yoursc/Robot/README.md

# 安防巡逻机器人，软硬件综合整理 #

--树莓派主板控制

--ROS系统

--STM32下位机
