yoursc/Robot/Code/Pi_ROS/ReadMe.md

系统核心层部署，本目录存放在树莓派上的部署步骤及运行的相关代码。

树莓派部署：
	安装Ubuntu Mate 最新版本
	安装软件
		RealVNC  远程控制工具
		minicom  串口调试工具
		pyserial python串口库
	设置静态IP（有线网络）
	使用ROS官方源安装完整的ROS
	下载使用到的ROS源码包
		usb_cam
		rosserial	git clone https://github.com/ros-drivers/rosserial.git
