yoursc/Robot/Code/STM32_Car/ReadMe.md

本目录存放STM32下位机。
程序代码参考：淘宝店平衡小车之家

芯片型号：STM32F103C8T6

串口通讯
波特率：115,200
数据位：8
停止位：1
