yoursc/Robot/论文/毕业设计调研_曹沛文.docx

应用场景

家庭机器人：安防、监控、互动、娱乐

细化功能

全向移动

视频云台

机械手

自主充电

高温自保护

烟雾检测

智能避障

语音识别

语音命令

人脸识别

远程控制

技术路线

评估：难度、时间精力、话费

工作计划
