yoursc/Robot/工程图/组装_安装板.SLDASM

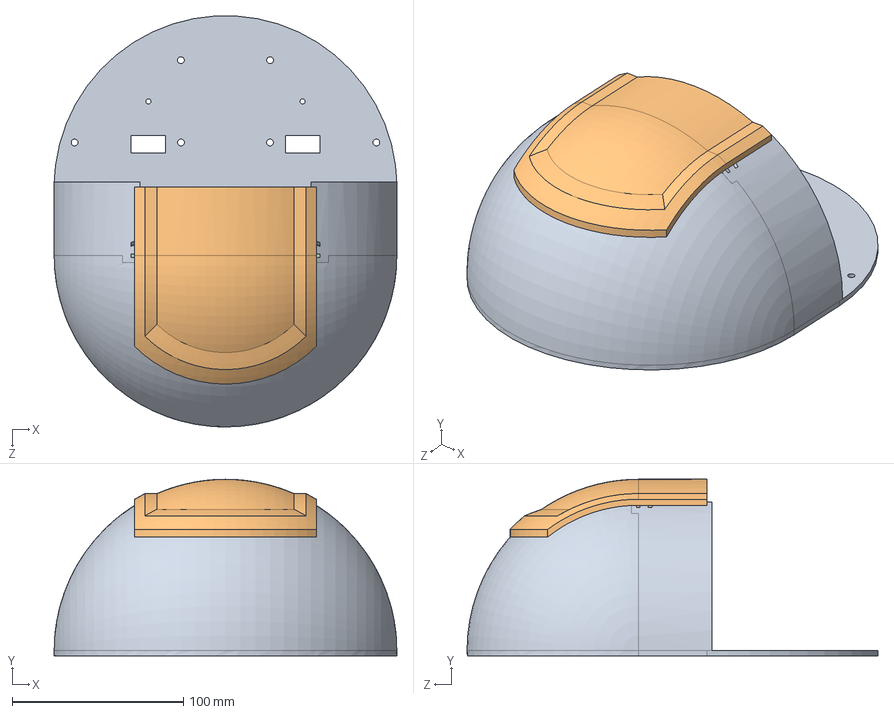
[picture p24: CAD file, 2018-05-11]
工程图/组装_安装板.SLDASM
200.0 x 103.0 x 239.8 mm
控制器安装盘
弧盖
控制板托架STM32
控制板托架树莓派
