yoursc/Robot/工程图/组装_总装.SLDASM

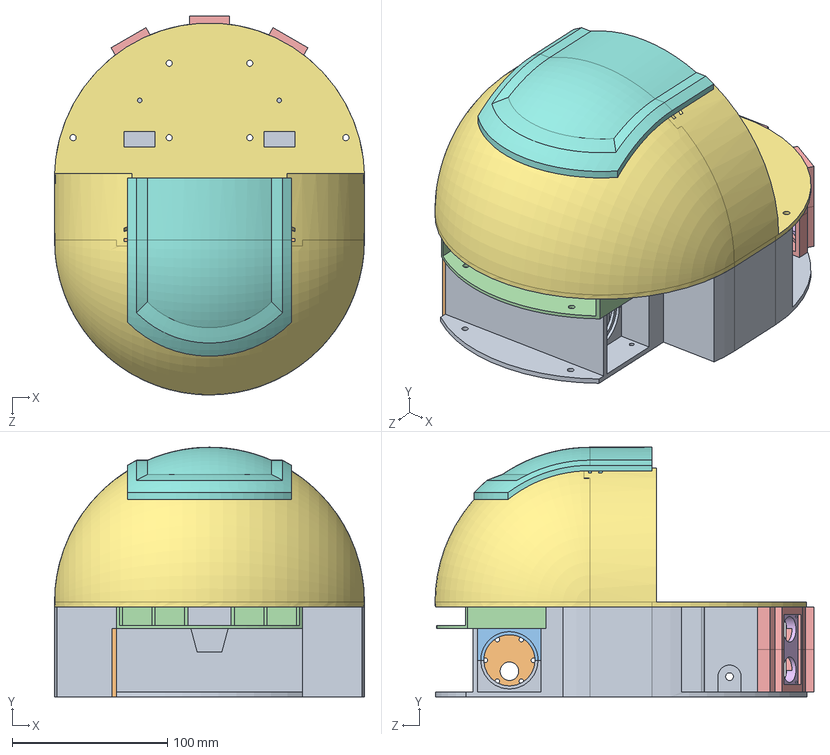
[picture p25: CAD file, 2018-05-11]
工程图/组装_总装.SLDASM
200.0 x 161.0 x 244.5 mm
小车底盘Pro
电机安装架
电机锁架 x 2
电机压板
车头前盖 x 2
超声波传感器安装板 x 3
控制器安装盘
弧盖
控制板托架STM32
控制板托架树莓派
