yoursc/Robot/工程图/组装_车头超声波.SLDASM

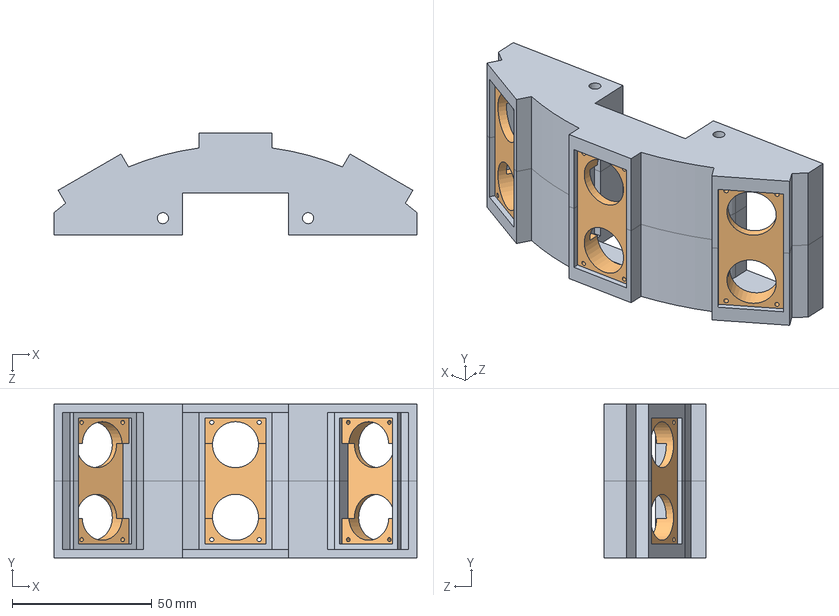
[picture p26: CAD file, 2018-05-11]
工程图/组装_车头超声波.SLDASM
130.0 x 55.0 x 36.5 mm
车头前盖 x 2
超声波传感器安装板 x 3
