yoursc/Robot/工程图/组装_底盘.SLDASM

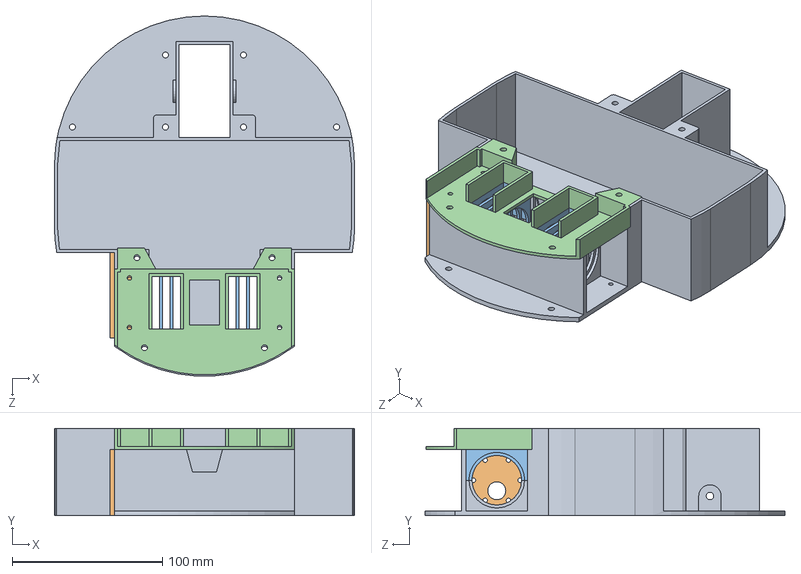
[picture p27: CAD file, 2018-05-11]
工程图/组装_底盘.SLDASM
200.0 x 58.0 x 239.8 mm
小车底盘Pro
电机安装架
电机锁架 x 2
电机压板
