yoursc/Robot/工程图/小车组装.SLDASM

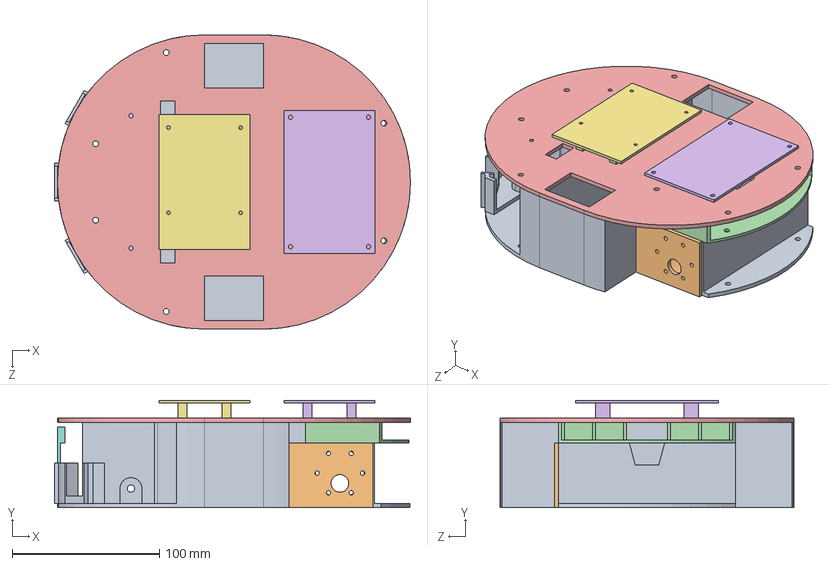
[picture p28: CAD file, 2018-04-24]
工程图/小车组装.SLDASM
242.0 x 73.0 x 200.0 mm
小车底盘Pro
电机安装架
电机锁架
电机压板
控制器安装盘
控制板托架STM32
控制板托架树莓派
超声波传感器安装板
车头前盖
