yoursc/Robot/工程图/控制器安装盘.SLDPRT

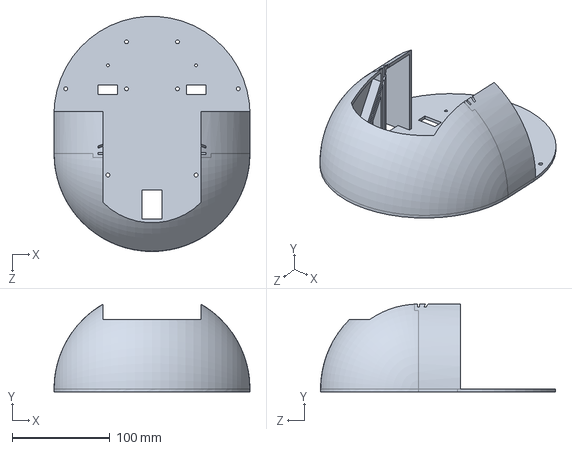
[picture p29: CAD file, 2018-05-15]
工程图/控制器安装盘.SLDPRT
200.0 x 89.6 x 239.8 mm
