yoursc/Robot/工程图/弧盖.SLDPRT

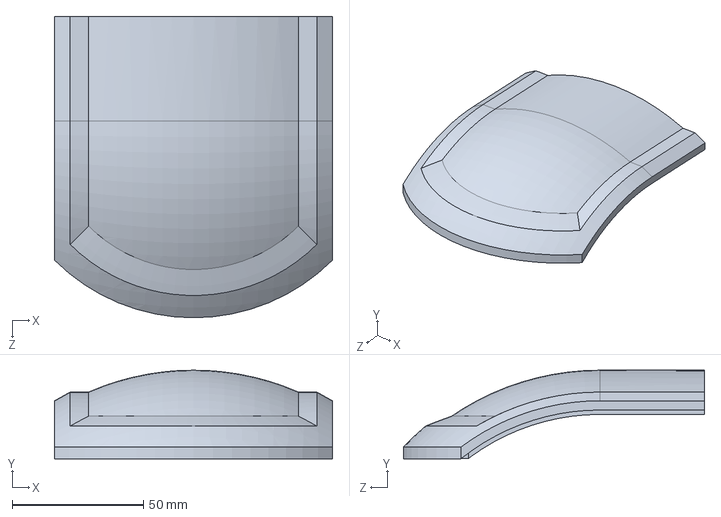
[picture p30: CAD file, 2018-05-06]
工程图/弧盖.SLDPRT
106.0 x 33.8 x 115.0 mm
