yoursc/Robot/工程图/控制板托架树莓派.SLDPRT

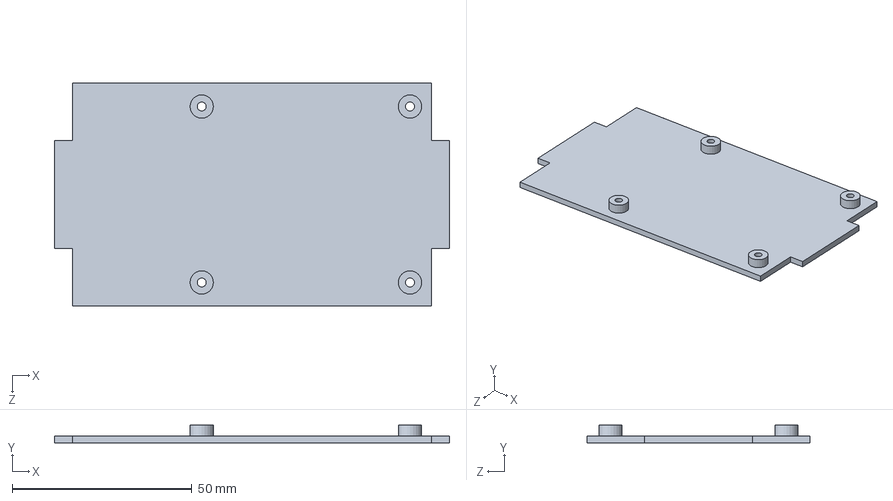
[picture p31: CAD file, 2018-05-06]
工程图/控制板托架树莓派.SLDPRT
110.0 x 5.00 x 62.0 mm
