yoursc/Robot/工程图/控制板托架STM32.SLDPRT

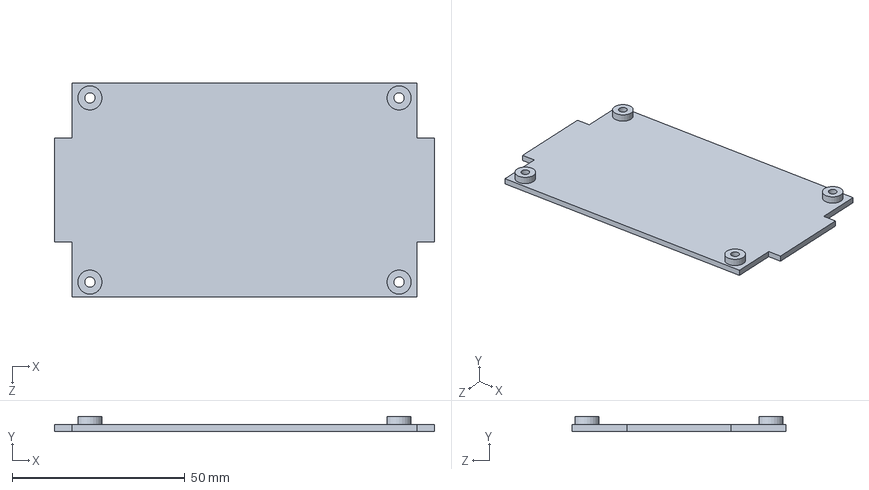
[picture p32: CAD file, 2018-05-06]
工程图/控制板托架STM32.SLDPRT
110.0 x 4.40 x 62.0 mm
