yoursc/Robot/工程图/车头前盖.SLDPRT

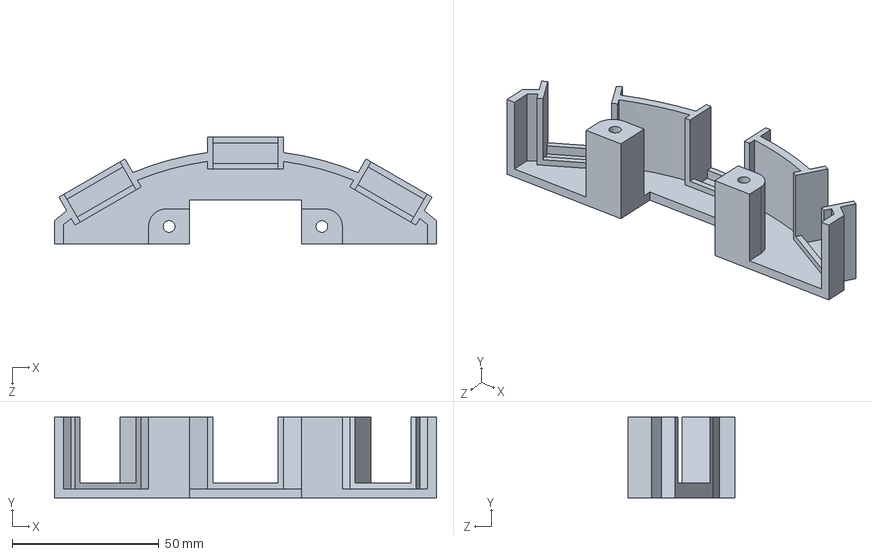
[picture p33: CAD file, 2018-05-02]
工程图/车头前盖.SLDPRT
130.0 x 27.5 x 36.5 mm
