yoursc/Robot/工程图/超声波传感器安装板.SLDPRT

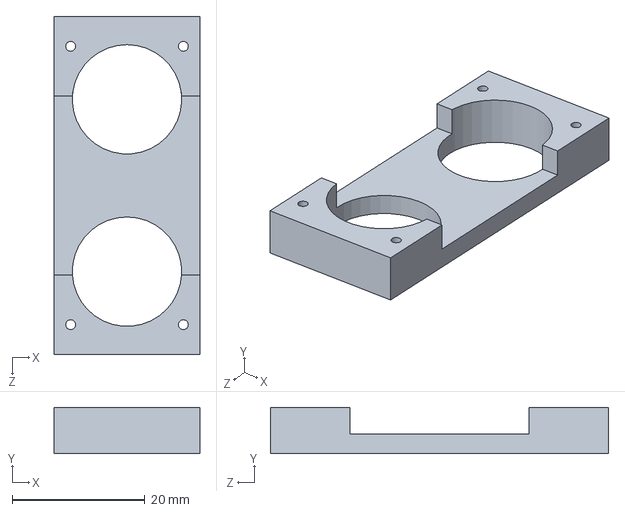
[picture p34: CAD file, 2018-05-02]
工程图/超声波传感器安装板.SLDPRT
22.0 x 7.00 x 51.0 mm
