yoursc/Robot/工程图/小车底盘Pro.SLDPRT

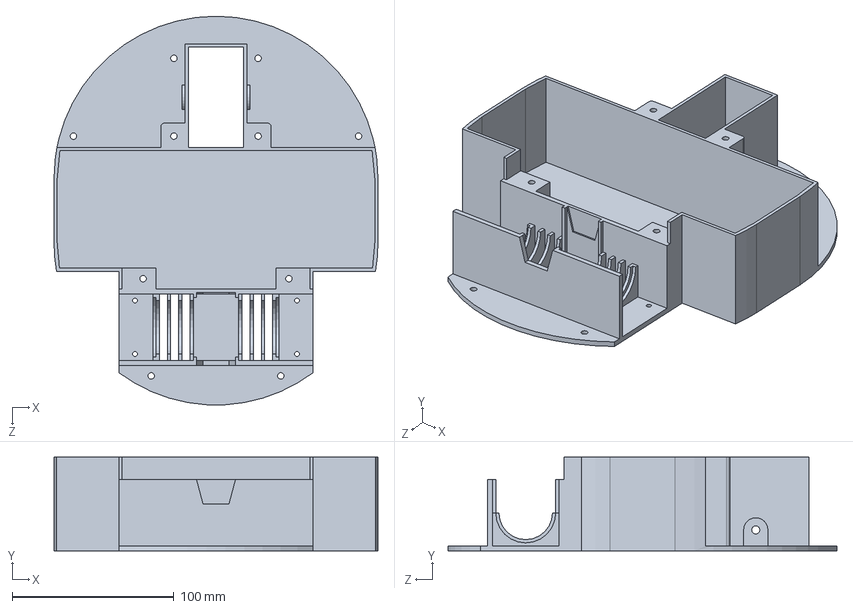
[picture p35: CAD file, 2018-04-11]
工程图/小车底盘Pro.SLDPRT
200.0 x 58.0 x 239.8 mm
