yoursc/Robot/工程图/电机压板.SLDPRT

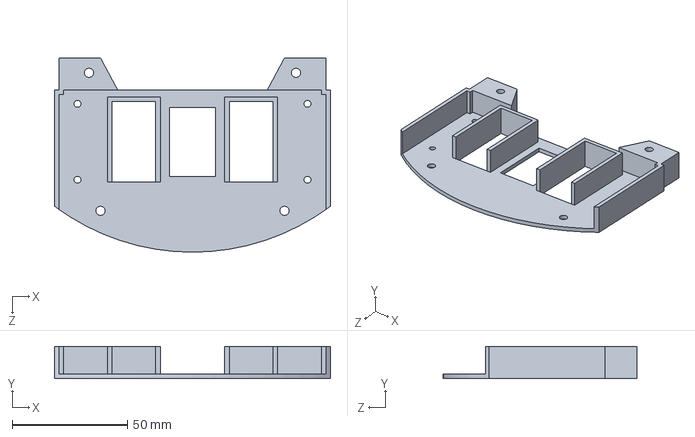
[picture p36: CAD file, 2018-04-08]
工程图/电机压板.SLDPRT
120.0 x 14.0 x 84.5 mm
