yoursc/Robot/工程图/电机锁架.SLDPRT

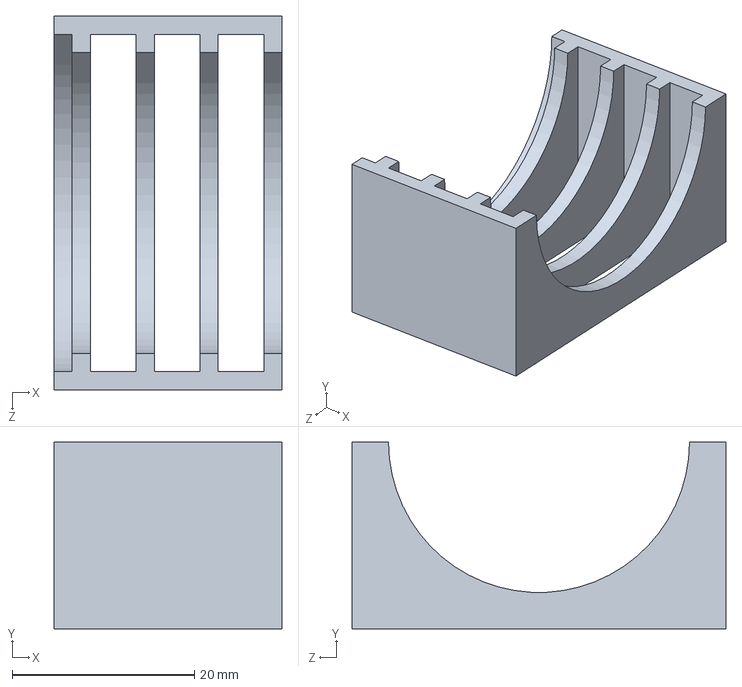
[picture p37: CAD file, 2018-04-08]
工程图/电机锁架.SLDPRT
25.0 x 20.5 x 41.0 mm
