yoursc/Robot/工程图/电机安装架.SLDPRT

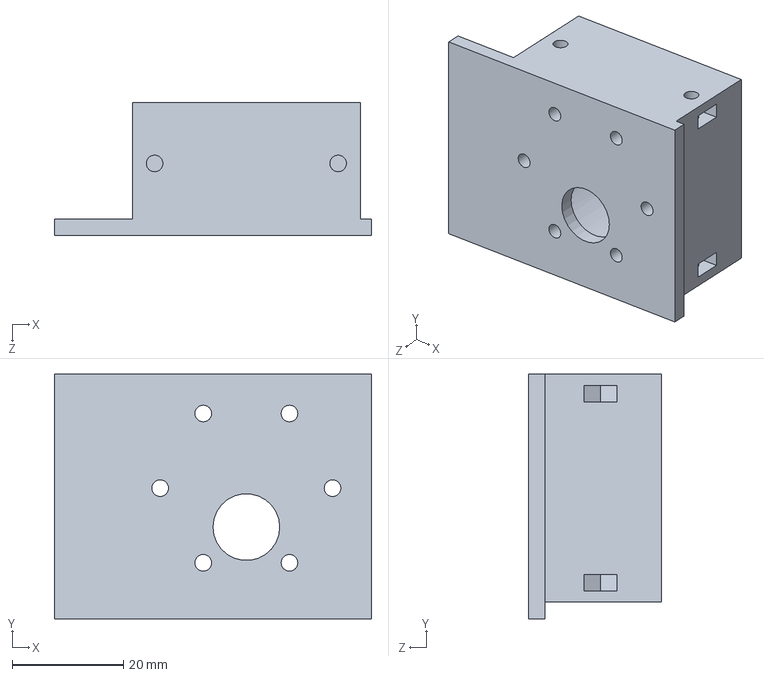
[picture p38: CAD file, 2018-04-08]
工程图/电机安装架.SLDPRT
57.0 x 44.0 x 24.0 mm
