yoursc/Robot/工程图/电机驱动器侧挂箱_顶盖.SLDPRT

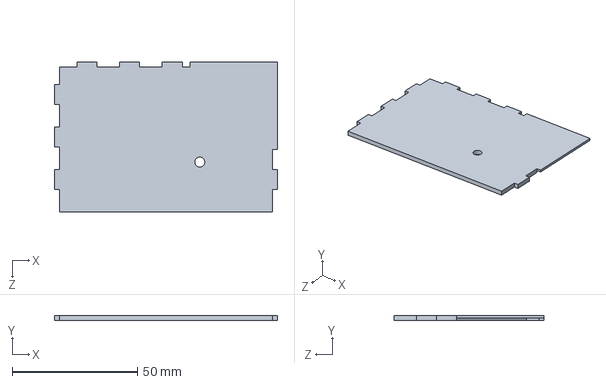
[picture p39: CAD file, 2017-11-21]
工程图/电机驱动器侧挂箱_顶盖.SLDPRT
89.0 x 2.00 x 60.0 mm
