yoursc/Robot/工程图/电机驱动器侧挂箱_主体.SLDPRT

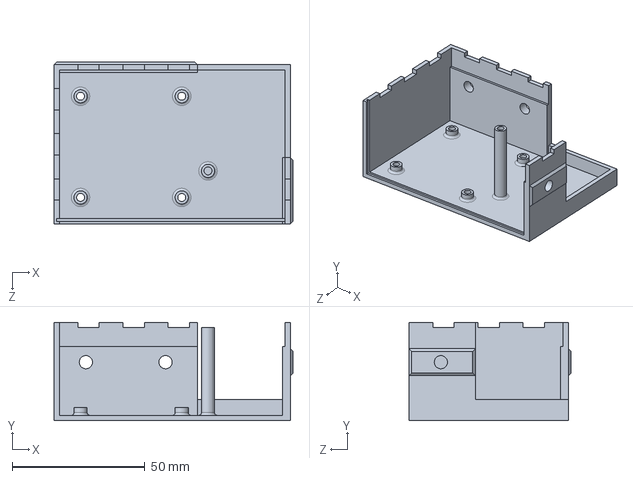
[picture p40: CAD file, 2017-11-21]
工程图/电机驱动器侧挂箱_主体.SLDPRT
90.0 x 37.0 x 61.0 mm
