yoursc/Robot/工程图/车轮连接板.SLDPRT

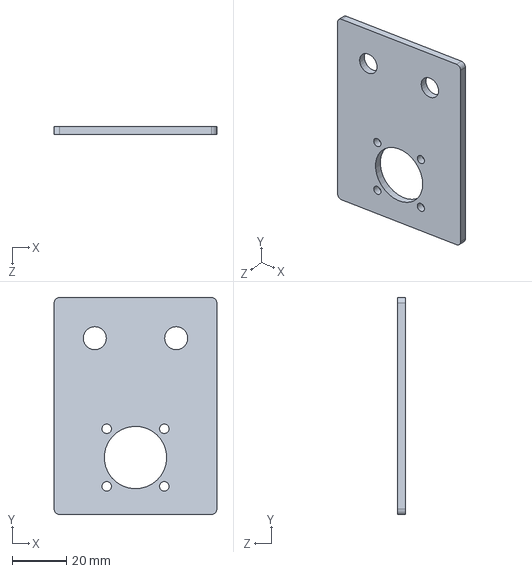
[picture p41: CAD file, 2017-10-17]
工程图/车轮连接板.SLDPRT
60.0 x 80.0 x 3.00 mm
