yoursc/Robot/(list of files, cad)

Other CAD files:
工程图/小车底盘Pro.SLDDRW
工程图/控制器安装盘.SLDDRW
工程图/电机驱动器侧挂箱_主体.SLDDRW
