yoursc/Robot/工程图/控制器安装盘.PDF

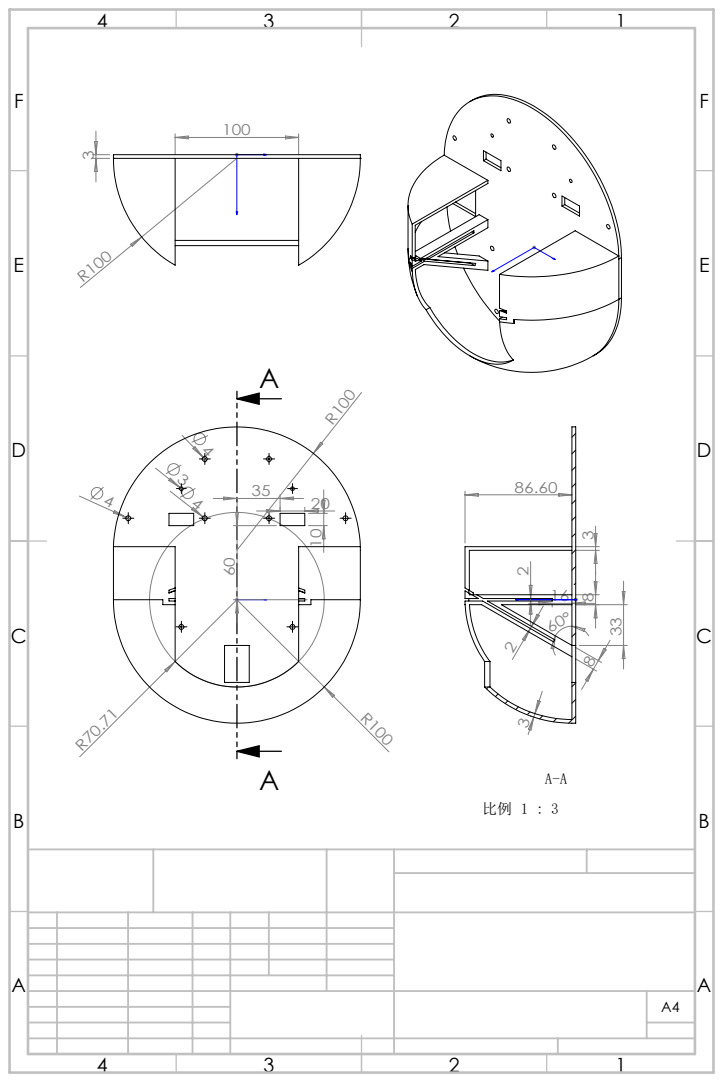
[picture p42: page 1]
