yoursc/Robot/工程图/小车底盘Pro.PDF

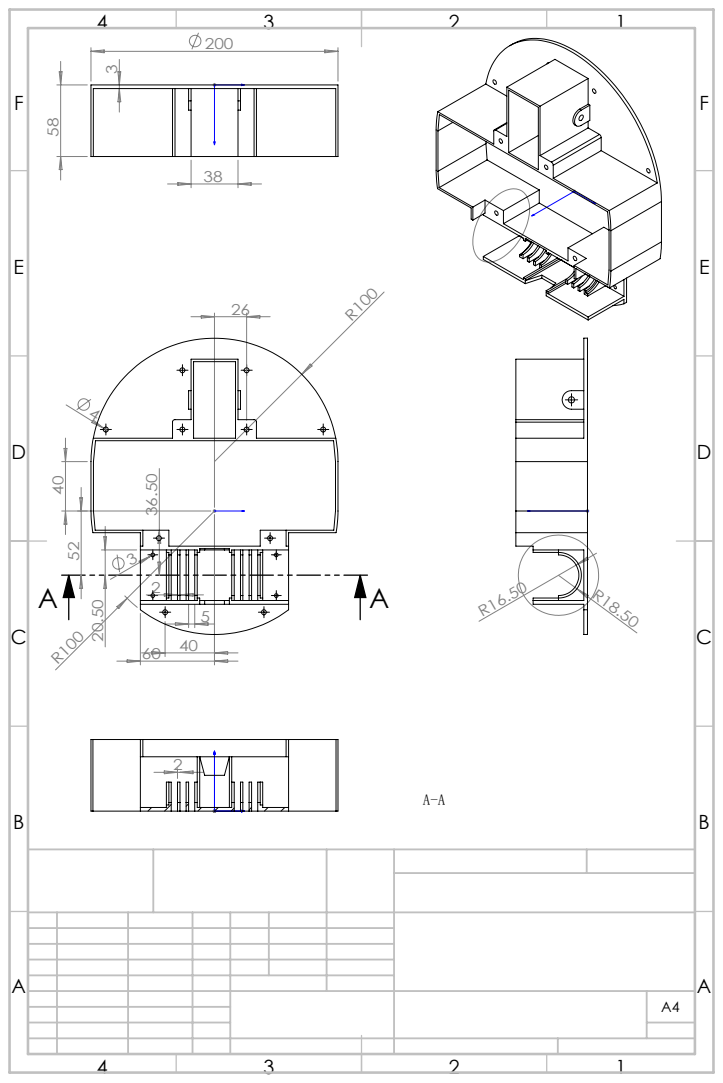
[picture p43: page 1]
