yoursc/Robot/(list of files, drawings)

Other design files:
Hardware/5V变压模块/5V变压模块.PrjPcb
Hardware/5V变压模块/5V变压模块.SchDoc
Hardware/5V变压模块/LM2596T.SchLib
Hardware/Connect_PCB/Connect_PCB.PcbDoc
Hardware/Connect_PCB/Connect_PCB.PrjPcb
Hardware/Connect_PCB/Connect_PCB.SchDoc
Hardware/STM32最小系统/ST32F103C8T6.SchLib
Hardware/STM32最小系统/STM32最小系统.PrjPcb
Hardware/STM32最小系统/STM32最小系统.SchDoc
Hardware/电压检测模块/电压检测模块.SchDoc
Hardware/电机驱动模块A4950/A4950.SchLib
Hardware/电机驱动模块A4950/电机驱动模块A4950.PrjPcb
Hardware/电机驱动模块A4950/电机驱动模块A4950.SchDoc
