yoursc/Robot/Code/STM32_Car/HARDWARE/inc/encoder.h

#ifndef __ENCODER_H
#define __ENCODER_H
#include <sys.h>	 
  /**************************************************************************
作者：平衡小车之家
我的淘宝小店：http://shop114407458.taobao.com/
**************************************************************************/
#define ENCODER_TIM_PERIOD (u16)(65535)   //不可大于65535 因为F103的定时器是16位的。
void Encoder_Init_TIM2(void);
void Encoder_Init_TIM3(void);
int Read_Encoder(u8 TIMX);
void EXTI1_IRQHandler(void);
void EXTI0_IRQHandler(void);
#endif
