yoursc/Robot/Code/STM32_Car/HARDWARE/inc/motor.h

#ifndef __MOTOR_H
#define __MOTOR_H
#include <sys.h>	 
  /**************************************************************************
作者：平衡小车之家
我的淘宝小店：http://shop114407458.taobao.com/
**************************************************************************/
#define PWMA1   TIM4->CCR1  
#define PWMA2   TIM4->CCR2 

#define PWMB1   TIM4->CCR3  
#define PWMB2   TIM4->CCR4

#define SERVO   TIM1->CCR4  //舵机引脚

void Motor_PWM_Init(u16 arr,u16 psc);
void Servo_PWM_Init(u16 arr,u16 psc);
#endif
