yoursc/Robot/Code/STM32_Car/HARDWARE/src/usart.c

#include "usart.h"	  
//加入以下代码,支持printf函数,而不需要选择use MicroLIB	  
#if 1
#pragma import(__use_no_semihosting)             
//标准库需要的支持函数                 
struct __FILE 
{ 
	int handle; 
	/* Whatever you require here. If the only file you are using is */ 
	/* standard output using printf() for debugging, no file handling */ 
	/* is required. */ 
}; 
/* FILE is typedef’ d in stdio.h. */ 
FILE __stdout;       
//定义_sys_exit()以避免使用半主机模式    
_sys_exit(int x) 
{ 
	x = x; 
} 
//重定义fputc函数 
int fputc(int ch, FILE *f)
{ 
	while((USART1->SR&0X40)==0);//Flag_Show!=0  使用串口1   
	USART1->DR = (u8) ch;    
	return ch;
}
#endif 
//end
//////////////////////////////////////////////////////////////////
/**************************实现函数**********************************************
*功    能:		usart1发送一个字节
*********************************************************************************/
void usart1_send(u8 data)
{
	USART1->DR = data;
	while((USART1->SR&0x40)==0);	
}
void uart_init(u32 pclk2,u32 bound)
{  	 
	float temp;
	u16 mantissa;
	u16 fraction;	   
	temp=(float)(pclk2*1000000)/(bound*16);//得到USARTDIV
	mantissa=temp;				 //得到整数部分
	fraction=(temp-mantissa)*16; //得到小数部分	 
    mantissa<<=4;
	mantissa+=fraction; 
	RCC->APB2ENR|=1<<2;   //使能PORTA口时钟  
	RCC->APB2ENR|=1<<14;  //使能串口时钟 
	GPIOA->CRH&=0XFFFFF00F;//IO状态设置
	GPIOA->CRH|=0X000008B0;//IO状态设置
		  
	RCC->APB2RSTR|=1<<14;   //复位串口1
	RCC->APB2RSTR&=~(1<<14);//停止复位	   	   
	//波特率设置
 	USART1->BRR=mantissa; // 波特率设置	 
	USART1->CR1|=0X200C;  //1位停止,无校验位.
	USART1->CR1|=1<<8;    //PE中断使能
	USART1->CR1|=1<<5;    //接收缓冲区非空中断使能	    	
	MY_NVIC_Init(0,1,USART1_IRQn,2);//组2，最低优先级 
}
/**************************************************************************
函数功能：串口1接收中断
入口参数：无
返回  值：无
**************************************************************************/
int USART1_IRQHandler(void)
{	
	if(USART1->SR&(1<<5))//接收到数据
	{	      
				u8 temp;
				static u8 count,last_data,last_last_data;
				temp=USART1->DR;
				   if(Usart_Flag==0)
						{	
						if(last_data==0xfe&&last_last_data==0xff) 
						Usart_Flag=1,count=0;	
						}
					 if(Usart_Flag==1)
						{	
							Urxbuf[count]=temp;     
							count++;                
							if(count==4)Usart_Flag=0;
						}
						last_last_data=last_data;
						last_data=temp;
   }
return 0;	
}
