yoursc/Robot/Code/STM32_Car/HARDWARE/src/usart2.c

#include "usart2.h"

void usart2_send(u8 data)
{
	USART2->DR = data;
	while((USART2->SR&0x40)==0);	
}
/**************************************************************************
函数功能：串口2初始化
入口参数：pclk2:PCLK2 时钟频率(Mhz)    bound:波特率
返回  值：无
**************************************************************************/
void uart2_init(u32 pclk2,u32 bound)
{  	 
	float temp;
	u16 mantissa;
	u16 fraction;	   
	temp=(float)(pclk2*1000000)/(bound*16);//得到USARTDIV
	mantissa=temp;				 //得到整数部分
	fraction=(temp-mantissa)*16; //得到小数部分	 
  mantissa<<=4;
	mantissa+=fraction; 
	RCC->APB2ENR|=1<<2;   //使能PORTA口时钟  
	RCC->APB1ENR|=1<<17;  //使能串口时钟 
	GPIOA->CRL&=0XFFFF00FF; 
	GPIOA->CRL|=0X00008B00;//IO状态设置
	GPIOA->ODR|=1<<10;	  
	RCC->APB1RSTR|=1<<18;   //复位串口1
	RCC->APB1RSTR&=~(1<<18);//停止复位	   	   
	//波特率设置
 	USART2->BRR=mantissa; // 波特率设置	 
	USART2->CR1|=0X200C;  //1位停止,无校验位.
	//使能接收中断
	USART2->CR1|=1<<8;    //PE中断使能
	USART2->CR1|=1<<5;    //接收缓冲区非空中断使能	    	
	MY_NVIC_Init(0,1,USART2_IRQn,2);//组2，最低优先级 
}


/**************************************************************************
函数功能：串口2接收中断
入口参数：无
返回  值：无
**************************************************************************/
int USART2_IRQHandler(void)
{	
	if(USART2->SR&(1<<5))//接收到数据
	{	      
				u8 temp;
				static u8 count,last_data,last_last_data;
				temp=USART2->DR;
				   if(Usart_Flag==0)
						{	
						if(last_data==0xfe&&last_last_data==0xff) 
						Usart_Flag=1,count=0;	
						}
					 if(Usart_Flag==1)
						{	
							Urxbuf[count]=temp;     
							count++;                
							if(count==4)Usart_Flag=0;
						}
						last_last_data=last_data;
						last_data=temp;
   }
return 0;	
}
