yoursc/Robot/(commit log)

2017-10-16 2017-10-16 添加调研和论文空白稿
2017-10-17 第一次3D打印的连接板
    [车轮连接板.SLDPRT]
2017-10-17 修改车轮连接板尺寸
    [车轮连接板.SLDPRT]
2017-10-24 添加README
2017-10-25 建立工程：小车地盘控制器
    [CarChassis.obj]
2017-10-25 开环的调试程序，带无PWM的指令控制函数
    [CarChassis.obj]
2017-10-27 优化变量命名规则及函数结构
    [CarChassis.obj]
2017-10-27 添加：电机驱动器悬挂安装外壳-主体
    [电机驱动器侧挂箱_主体.SLDPRT]
2017-11-19 修改：电机驱动器挂箱，增加主板螺丝孔和外盖卡槽
    [电机驱动器侧挂箱_主体.SLDPRT]
2017-11-21 修改：电机驱动器侧挂箱_主体-增加顶盖螺丝柱
    [电机驱动器侧挂箱_主体.SLDPRT]
2017-11-21 增加：电机驱动器侧挂箱_主体 工程图
    [电机驱动器侧挂箱_主体.SLDDRW]
2017-11-21 增加：电机驱动器侧挂箱_顶盖 模型
    [电机驱动器侧挂箱_顶盖.SLDPRT]
2017-11-25 修改CarChassis.c
2017-12-03 硬件测试代码
2017-12-03 小车地盘驱动主程序
2017-12-07 添加：对xbox360手柄的Python驱动程序
2017-12-07 优化：Xbox360驱动代码
2017-12-07 新增：电机驱动代码库
2017-12-08 新功能：Xbox360手柄的按键控制小车
2017-12-08 修改控制口
2017-12-08 修改：控制过程中的BUG
2017-12-28 文件整理
    [CarChassis.obj]
2017-12-28 添加：python单动作初代代码
2018-02-24 修改论文名称，修改摘要
2018-02-24 微调：手柄直控程序
2018-03-05 修改：完善第一章_背景意义
2018-03-06 撰写：第一章_背景意义
2018-03-07 撰写：第二章_系统设计，功能预期和总系统方案
2018-03-07 调整：更改项目文件结构
2018-03-08 撰写：第二章_系统总方案设计&控制层设计
2018-03-09 撰写：第二章：核心层系统设计
2018-03-10 修改：第二章：核心层
2018-03-11 撰写：第二章：核心层系统算法结构
2018-03-16 添加：程序：小车32下位机程序（第三方参考本未修改）
2018-03-17 调整：程序：小车地盘：调整程序结构和编码
2018-03-17 撰写：第三章：硬件设计（开稿）
2018-03-18 添加：程序：核心层串口接收测试脚本
2018-03-18 撰写：日志：解决串口权限问题报告
2018-04-05 添加：小车地盘设计图（雏形）
2018-04-05 添加：小车地盘设计图纸
    [小车底盘.SLDPRT]
2018-04-06 添加：底盘及电机安装零件
    [小车底盘.SLDPRT, 小车底盘Pro.SLDPRT, 电机安装架.SLDPRT, 电机锁架.SLDPRT]
2018-04-06 修改：完善小车底盘设计
    [小车底盘Pro.SLDPRT]
2018-04-08 添加：多个工程图设计
    [小车底盘Pro.SLDPRT, 小车组装.SLDASM, 控制器安装盘.SLDPRT, 控制板托架STM32.SLDPRT, 控制板托架树莓派.SLDPRT, 电机压板.SLDPRT, 电机安装架.SLDPRT, 电机锁架.SLDPRT]
2018-04-11 修改：小车工程图
    [小车底盘Pro.SLDPRT, 小车组装.SLDASM, 控制器安装盘.SLDPRT]
2018-04-11 修改：调整目录结构
2018-04-11 修改：文章目录扩展
2018-04-12 修改：串口测试程序，完善代码
2018-04-14 添加：PCB板设计，已编辑主要模块的封装库
    [Connect_PCB.PcbDoc, Connect_PCB.PrjPcb, Connect_PCB.SchDoc]
2018-04-14 修改：原理图绘制完成
    [Connect_PCB.PcbDoc, Connect_PCB.SchDoc]
2018-04-14 修改：绘制PCB前最后一次修改
    [Connect_PCB.SchDoc]
2018-04-15 修改：PCB板绘制完成
    [Connect_PCB.PcbDoc, Connect_PCB.PrjPcb, Connect_PCB.SchDoc]
2018-04-15 修改：电源电路存在重大设计缺陷，已修改
    [Connect_PCB.PcbDoc, Connect_PCB.PrjPcb, Connect_PCB.SchDoc]
2018-04-16 修改：PCB布线排错
    [Connect_PCB.PcbDoc, Connect_PCB.PrjPcb, Connect_PCB.SchDoc]
2018-04-17 修改：添加变压模块电路图
    [5V变压模块.PrjPcb, 5V变压模块.SchDoc, LM2596T.SchLib]
2018-04-17 添加：电压检测模块电路图
    [电压检测模块.SchDoc]
2018-04-17 添加：电机驱动模块A4950电路图
    [A4950.SchLib, 电机驱动模块A4950.PrjPcb, 电机驱动模块A4950.SchDoc]
2018-04-17 修改：电机驱动模块A4950
    [电机驱动模块A4950.SchDoc]
2018-04-17 撰写：修改电源、电机驱动 小节
2018-04-18 添加：树莓派超声波测距程序
2018-04-20 添加：PCB板实物检测报告
2018-04-20 撰写：写了大量的内容
2018-04-20 添加：最小系统板原理图
    [ST32F103C8T6.SchLib, STM32最小系统.PrjPcb, STM32最小系统.SchDoc]
2018-04-21 撰写：上位机配置及超声波测距
2018-04-24 撰写：初稿截稿
2018-04-24 添加：测试数据
    [测试数据.xlsx]
2018-04-24 添加：超声波模块安装架工程图
    [小车底盘Pro.SLDDRW, 小车组装.SLDASM, 超声波传感器安装板.SLDPRT, 车头前盖.SLDPRT]
2018-04-29 修改：内容微调
    [5V变压模块.SchDoc, 小车底盘Pro.SLDDRW, 电压检测模块.SchDoc, 电机驱动模块A4950.SchDoc]
2018-04-29 修改：论文第二次大改
2018-04-29 修改：第二次修改--继续改
2018-04-30 撰写：继续写
    [测试数据.xlsx]
2018-05-02 修改：曹圣伯传感器安装板
    [超声波传感器安装板.SLDPRT]
2018-05-02 修改：车头前盖
    [车头前盖.SLDPRT]
2018-05-02 修改：控制器安装盘增加弧形顶
    [控制器安装盘.SLDPRT, 控制板托架STM32.SLDPRT, 控制板托架树莓派.SLDPRT]
2018-05-06 修改：控制器托盘
    [控制板托架STM32.SLDPRT, 控制板托架树莓派.SLDPRT]
2018-05-06 设计：弧形顶盖
    [弧盖.SLDPRT]
2018-05-06 新建：ROS超声波节点
2018-05-06 修改：创建Distance消息
2018-05-07 开发：超声波测距-ROS节点-Python框架
2018-05-08 开发：ROS超声波测距节点
2018-05-08 开发：距离处理节点
2018-05-09 开发：距离处理逻辑以完成
2018-05-09 开发：增加串口发送功能
2018-05-10 整合：修正目录结构，增加所有程序包文件，未编译
2018-05-10 调整：文件目录整理后整体失效的修复（已修复）
2018-05-10 开发：添加电机速度消息格式及订阅发布
2018-05-10 开发：将串口发送功能剥离成一个节点，控制命令发送至串口发送订阅，增加Serial_Send.msg消息格式
2018-05-11 编辑：整合工程图，制作装配体
    [小车底盘.SLDPRT]
2018-05-11 开发：增加BMP180传感器节点，及其订阅消息格式
2018-05-15 添加：工程图
    [控制器安装盘.SLDDRW, 控制器安装盘.SLDPRT]
2018-05-15 论文：最后的修改
    [测试数据.xlsx]
2018-05-25 添加：存档打印版
2018-05-25 修改：打印版格式修改
2018-06-15 毕业设计完结（5月底就完结了，忘记推送了）
